Pekaway/ESP32-BLE-WIFI-SHUNT/docs/3D Renderings/Side.png

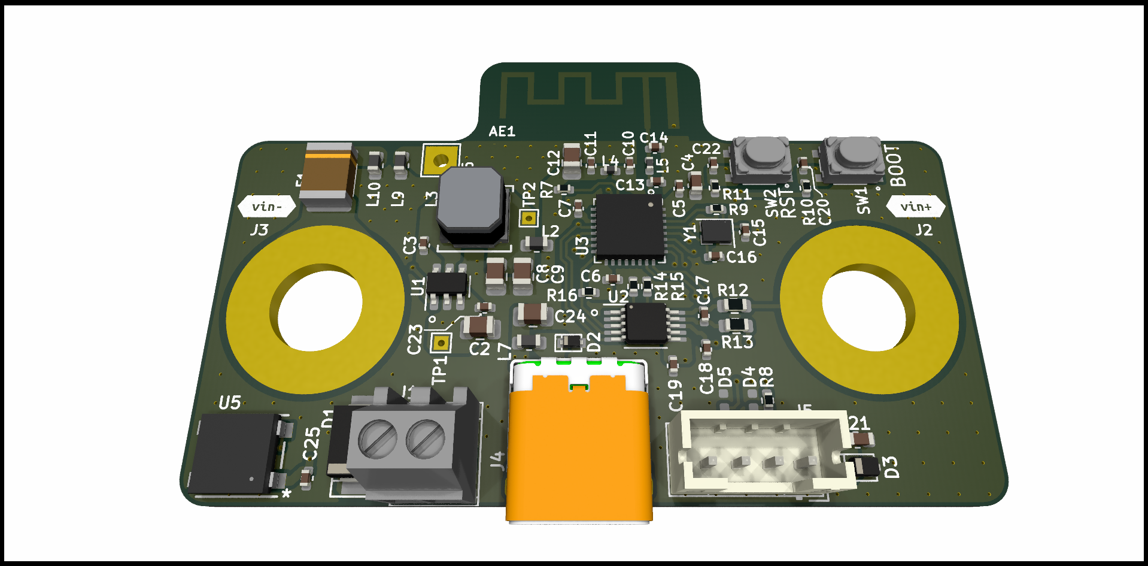
docs/3D Renderings/Side.png
