Pekaway/ESP32-BLE-WIFI-SHUNT/docs/3D Renderings/Top.png

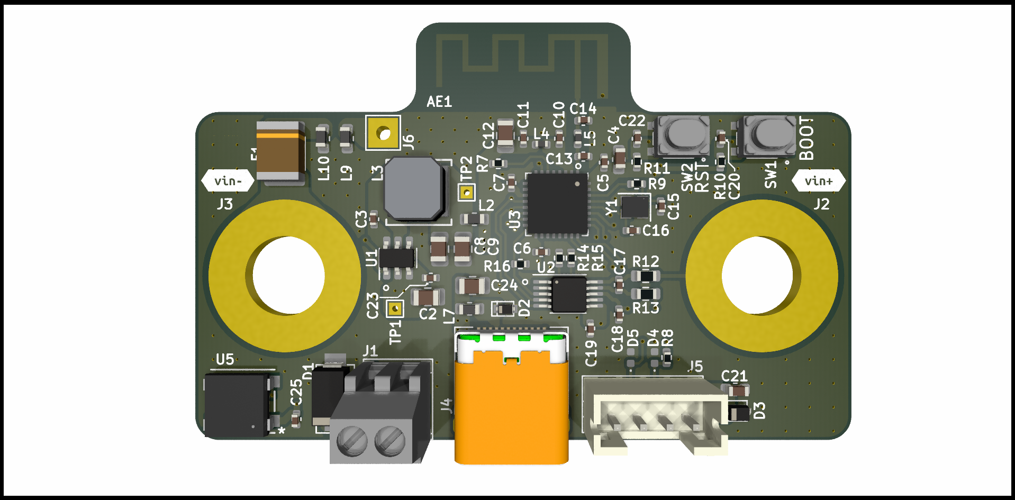
docs/3D Renderings/Top.png
