Pekaway/ESP32-BLE-WIFI-SHUNT/docs/3D Renderings/Angle 1.png

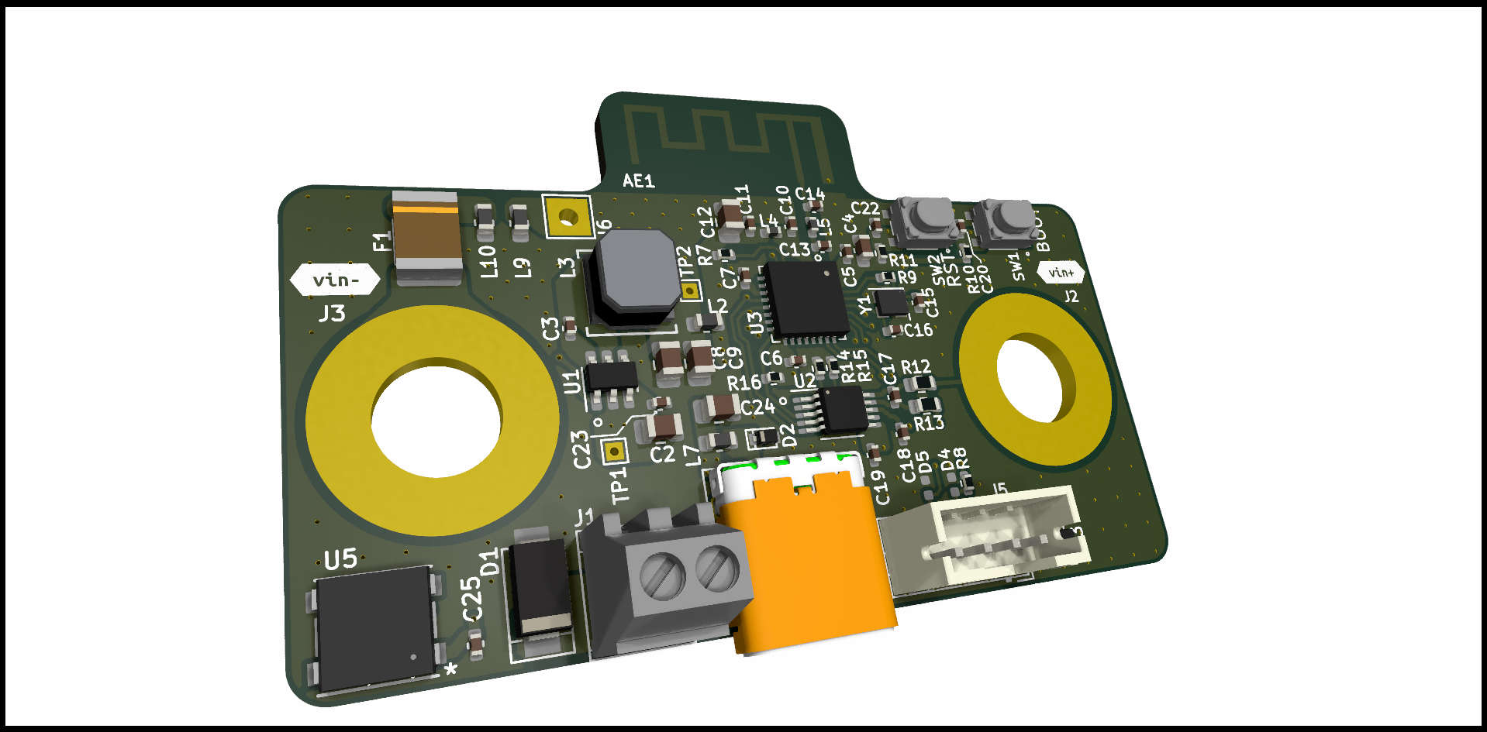
docs/3D Renderings/Angle 1.png
