Pekaway/ESP32-BLE-WIFI-SHUNT/docs/3D Renderings/Bottom.png

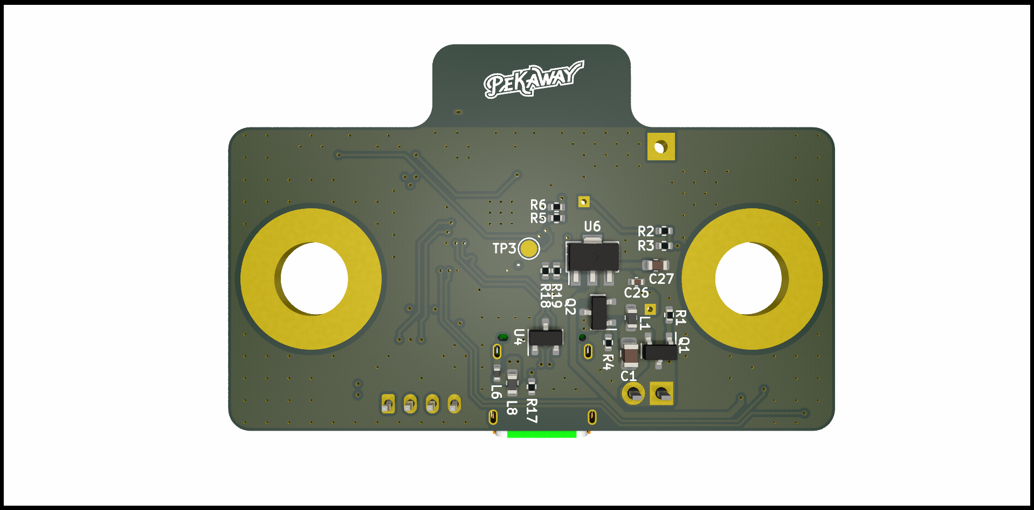
docs/3D Renderings/Bottom.png
