Pekaway/ESP32-BLE-WIFI-SHUNT/(threads)

Thread 1 (2024-09-11):

Update Punkte

WulleOnTour, 2024-09-11:
- Endpunke Bluetooth - Alle Einstellung die zum Shunt übertragen werden sollte auch Auslesbar sein
- Ladewirkunksgrad einstellbar Bsp: LFP 99% , Blei 95%.  Heißt bei einen Ladestrom von 10A in der Stunde, wird bei LFP nur 9,9Ah hinzu addiert, Bei Blei nur 9,5Ah

- Ladezustanderkennung wenn Baatterie Voll
	Spannung  - Ladeschlussspannung - Sollte ca 0,2 Volt unter der eigentlichen Ladespannung eingestellt sein.
	Strom  - (Bei Victron aus der Kapazität der Batterie Berechnet in Prozent - 300Ah 2% = 6a /Schweifstrom)
	Zeit   - (Victron - Zeit f. Ladezustand-Erkennung)
	Es muss die Spannung erreicht sein, sowie der Ladestrom unter den Wert X gefallen sein und das für mindesten Zeit X. Damit ist dann Sicher das die Batterie zu 100 % voll ist.

-2ter Input ADC
	Spannungsanzeige für Starterbatterie
	oder Mittelpunkt Bsp. 24 Volt System aus 12 Volt Batterien, Abweichung in Prozent

- Endladen (Peukert-Exponent)
	https://www.victronenergy.com/media/pg/SmartShunt_IP65/de/battery-capacity-and-peukert-exponent.html
	Eventuell einfach als Faktor angeben. Bsp. Faktor 1,1  bei 1A last wird 1,1Ah gezählt / 10a = 11Ah Eher bei Blei Batterien Intressant.

- Strom Schwellwert (Victron)
	Messfilter für kleine Ströme, also unter Wert Bsp. 0,01a wird als 0 erkannt.
	https://www.victronenergy.com/media/pg/SmartShunt_IP65/de/all-features-and-settings.html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

Thread 2 (2024-11-04):

Pinout of PCB components

dschmag, 2024-11-04:
Hi,
Is there a schematic or any documentation to find the correct pinout for
- I2C
- ws2812 led
- the buttons

I2C seems to be default, but that depends on the lib you use, I tried GPIO8 (SDA), GPIO9 (SCL), which did NOT work
a schematic would help a lot

I'm currently preparing an esphome config for this device (see https://esphome.io/components/sensor/ina226.html) so also the i2c address would be needed

dschmag, 2024-11-07:
Thanks,
works now with esphome in Home Assistant (sensors show up, but I did not test with current etc yet)

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

```

esphome:
  name: pekawayshut
  friendly_name: pekawayshut

esp32:
  board: esp32-c3-devkitm-1
  variant: esp32c3
  framework:
    type: arduino

# Enable logging
logger:
  level: DEBUG #VERY_VERBOSE

# Enable Home Assistant API
api:
  encryption:
    key: "xxxx"

ota:
  - platform: esphome
    password: "xxxx"

wifi:
  networks:
    - ssid: !secret wifi_ssid
      password: !secret wifi_password

  # Enable fallback hotspot (captive portal) in case wifi connection fails
  ap:
    ssid: "Pekawayshut Fallback Hotspot"
    password: "xxx"

captive_portal:

# https://esphome.io/components/i2c#i2c
# not default pins https://github.com/espressif/arduino-esp32/blob/master/variants/esp32c3/pins_arduino.h
i2c:
  sda: GPIO7
  scl: GPIO6
  scan: true # for debugging

# https://esphome.io/components/sensor/ina226.html
sensor:
  - platform: ina226 # from image name in repo and https://github.com/Pekaway/ESP32-BLE-WIFI-SHUNT/blob/main/docs/ESP32%20Shunt%20V2%20-%20Design%20Notes.pdf
    address: 0x40
    shunt_resistance: 0.000375 ohm # from https://github.com/Pekaway/ESP32-BLE-WIFI-SHUNT/blob/main/Esp32c3_Shunt_BLE_0.1.ino
    max_current: 1022 A # to check
    # adc time used for both, Bus Voltage and Shunt Voltage
    adc_time: 140 us
    adc_averaging: 4
    update_interval: 1s
    current:
      name: "INA226 Current"
    power:
      name: "INA226 Power"
    bus_voltage:
      name: "INA226 Bus Voltage"
    shunt_voltage:
      name: "INA226 Shunt Voltage"

# https://esphome.io/components/light/neopixelbus.html
light:
  - platform: neopixelbus
    type: GRB
    variant: WS2812
    pin: GPIO4
    num_leds: 1
    name: "NeoPixel Light"
```

Closed 2024-11-07.
