Pekaway/ESP32-BLE-WIFI-SHUNT/src/sensors/Shunt.cpp

#include "Shunt.h"
#include "../constants.h"
#include "../utils/ConfigManager.h"

Shunt& Shunt::getInstance() {
  static Shunt instance;
  return instance;
}

Shunt::Shunt() {
  logger.prependLog = [] { return "SHUNT"; };
}

bool Shunt::init() {
  ConfigManager& config = ConfigManager::getInstance();

  this->chargeEfficiency = config.get<uint8_t>(ConfigKey::CHARGE_EFFICIENCY);

  deviceCount = ina.begin(SHUNT_MAXIMUM_AMPS, SHUNT_MICRO_OHM, 255, 7, 6);
  while (deviceCount == 0) {
    logger.critical("No INA device found, retrying in 10 seconds...");
    delay(10000);
    deviceCount = ina.begin(SHUNT_MAXIMUM_AMPS, SHUNT_MICRO_OHM, 255, 7, 6);
  }

  char message[50];
  snprintf(message, sizeof(message), "Detected %d INA devices on the I2C bus", deviceCount);
  logger.info(message);

  ina.setBusConversion(8500);
  ina.setShuntConversion(8500);
  ina.setAveraging(128);
  ina.setMode(INA_MODE_CONTINUOUS_BOTH);
  ina.alertOnBusOverVoltage(true, 16000);

  loadConfig();

  return true;
}

double Shunt::getBusVoltage() { return ina.getBusMilliVolts(0) / 1000.0; }

double Shunt::getBusCurrent() {
  // negative is charging, positive is discharging
  return ina.getBusMicroAmps(0) / 1000000.0 * -1.0;
}

double Shunt::getPower() { return ina.getBusMicroWatts(0) / 1000000.0 * -1.0; }

double Shunt::getStateOfCharge() const { return calculateStateOfCharge(); }

void Shunt::setMaxCapacity(uint16_t const ampHours) {
  maxCapacityMilliAmpMs = ampHours * 60LL * 60LL * 1000LL * 1000LL;

  ConfigManager& config = ConfigManager::getInstance();
  config.set(ConfigKey::MAXIMUM_CAPACITY_MAMS, maxCapacityMilliAmpMs);
  config.saveConfig();

  char message[50];
  snprintf(message, sizeof(message), "Max capacity set to %d Ah", ampHours);
  logger.info(message);
}

void Shunt::setCurrentStateOfCharge(uint8_t percentage) {
  if (percentage > 100) percentage = 100;
  currentCapacityMilliAmpMs = (maxCapacityMilliAmpMs / 100) * percentage;

  saveStateToConfig();
  lastStoredCapacityMilliAmpMs = currentCapacityMilliAmpMs;

  char message[50];
  snprintf(message, sizeof(message), "SOC set to %d%%", percentage);
  logger.info(message);
}

void Shunt::setChargeEfficiency(uint8_t percentage) {
  if (percentage > 100) percentage = 100;

  ConfigManager& config = ConfigManager::getInstance();
  config.set<uint8_t>(ConfigKey::CHARGE_EFFICIENCY, percentage);
  config.saveConfig();

  this->chargeEfficiency = percentage;

  char message[50];
  snprintf(message, sizeof(message), "Charge efficiency set to %d%%", percentage);
  logger.info(message);
}

double Shunt::getChargeEfficiency() const { return this->chargeEfficiency; }

uint64_t Shunt::getMaxCapacity() const { return maxCapacityMilliAmpMs / (60LL * 60LL * 1000LL * 1000LL); }

bool Shunt::loadConfig() {
  ConfigManager& config = ConfigManager::getInstance();

  maxCapacityMilliAmpMs = config.get<uint64_t>(ConfigKey::MAXIMUM_CAPACITY_MAMS, 100LL * 60LL * 60LL * 1000LL * 1000LL);
  logger.info(String(maxCapacityMilliAmpMs).c_str());

  if (config.hasKey(ConfigKey::CURRENT_CAPACITY_MAMS)) {
    currentCapacityMilliAmpMs = config.get<long long>(ConfigKey::CURRENT_CAPACITY_MAMS);
  }

  fullChargeVoltage = config.get<float>(ConfigKey::FULL_CHARGE_VOLTAGE);
  fullChargeCurrent = config.get<float>(ConfigKey::FULL_CHARGE_CURRENT);
  fullChargeDuration = config.get<uint32_t>(ConfigKey::FULL_CHARGE_DURATION) * 60 * 1000;

  lastStoredCapacityMilliAmpMs = currentCapacityMilliAmpMs;

  char message[100];
  snprintf(message, sizeof(message), "Loaded max capacity: %lld mA-ms, SOC: %f%%", maxCapacityMilliAmpMs,
           calculateStateOfCharge());
  logger.info(message);

  return true;
}

void Shunt::saveStateToConfig() const {
  ConfigManager& config = ConfigManager::getInstance();

  config.set(ConfigKey::CURRENT_CAPACITY_MAMS, currentCapacityMilliAmpMs);
  config.saveConfig();
}

void Shunt::update() {
  auto const currentMillis = millis();

  if (lastUpdateMillis > 0) {
    uint64_t capacityDeltaMilliAmpMs = 0;
    // Calculate consumed or recharged capacity since last update
    auto const elapsedMs = currentMillis - lastUpdateMillis;
    auto const busCurrent = getBusCurrent();

    if (busCurrent > 0.0f) {
      // Charging
      uint64_t const currentAmps = abs(busCurrent) * chargeEfficiency / 100;
      capacityDeltaMilliAmpMs = (currentAmps * 1000 * elapsedMs);

      currentCapacityMilliAmpMs += capacityDeltaMilliAmpMs;
    } else if (busCurrent < 0.0f) {
      // Discharging
      capacityDeltaMilliAmpMs = (abs(busCurrent) * 1000 * elapsedMs);

      currentCapacityMilliAmpMs -= capacityDeltaMilliAmpMs;
    }

    clampStateOfCharge();
  }

  auto const voltage = getBusVoltage();
  auto const current = getBusCurrent();
  auto const soc = calculateStateOfCharge();

  // Both conditions must be met:
  // 1. Voltage must be at or above threshold
  // 2. Current must be below threshold but greater than zero
  bool const chargingConditionsMet = (voltage >= fullChargeVoltage) && (current < fullChargeCurrent) &&
                                     (current > 0.0) && (soc < 99.0);  // Only trigger if not already at 100%

  if (chargingConditionsMet) {
    if (!fullChargeConditionMet) {
      fullChargeConditionMet = true;
      fullChargeConditionStartTime = currentMillis;
      logger.info("Full charge conditions detected, starting timer");
    } else if (currentMillis - fullChargeConditionStartTime >= fullChargeDuration) {
      logger.info("Battery full charge criteria met for required duration");
      setCurrentStateOfCharge(100);
      fullChargeConditionMet = false;
    }
  } else if (fullChargeConditionMet) {
    fullChargeConditionMet = false;
    logger.info("Full charge conditions no longer met, resetting timer");
  }

  if (constexpr auto autoSaveInterval = AUTO_SAVE_INTERVAL * 1000;
      currentMillis - lastStorageMillis >= autoSaveInterval) {
    lastStorageMillis = currentMillis;

    if (fullChargeConditionMet) {
      currentCapacityMilliAmpMs = maxCapacityMilliAmpMs;
    }

    saveStateToConfig();
    lastStoredCapacityMilliAmpMs = currentCapacityMilliAmpMs;
  }

  lastUpdateMillis = currentMillis;
}

double Shunt::calculateStateOfCharge() const {
  if (maxCapacityMilliAmpMs <= 0) return 0;

  return static_cast<double>(currentCapacityMilliAmpMs) / maxCapacityMilliAmpMs * 100;
}

double Shunt::getTTGO() {
  double ttgo = 0.0;
  constexpr double maxTTGO = 9999.0;

  if (double const busCurrent = getBusCurrent(); busCurrent > 0.01f) {
    // Charging - calculate time to full
    uint64_t const remaining_capacity_milli_amp_ms = maxCapacityMilliAmpMs - currentCapacityMilliAmpMs;
    int64_t const chargingCurrentMilliA = abs(busCurrent) * 1000.0f * (static_cast<float>(chargeEfficiency) / 100.0f);

    if (chargingCurrentMilliA > 0) {
      return remaining_capacity_milli_amp_ms / chargingCurrentMilliA;
    }
    ttgo = maxTTGO;
  } else if (busCurrent < -0.01f) {
    // Discharging - calculate time remaining
    double const dischargingCurrentMilliA = abs(busCurrent * 1000.0f);

    if (dischargingCurrentMilliA > 0) {
      return static_cast<double>(currentCapacityMilliAmpMs) / dischargingCurrentMilliA;
    }
    ttgo = maxTTGO;
  } else {
    // Current near zero - consider it infinite or N/A
    ttgo = maxTTGO;
  }

  // Convert hours to milliseconds for return value
  return ttgo * 60.0 * 60.0 * 1000.0;
}

void Shunt::clampStateOfCharge() {
  if (currentCapacityMilliAmpMs > maxCapacityMilliAmpMs) {
    currentCapacityMilliAmpMs = maxCapacityMilliAmpMs;
  }

  if (currentCapacityMilliAmpMs < 0) {
    currentCapacityMilliAmpMs = 0;
  }
}

void Shunt::setFullChargeVoltage(float const voltage) {
  ConfigManager& config = ConfigManager::getInstance();
  fullChargeVoltage = voltage;
  config.set<float>(ConfigKey::FULL_CHARGE_VOLTAGE, voltage);
  config.saveConfig();

  char message[50];
  snprintf(message, sizeof(message), "Full charge voltage set to %.1fV", voltage);
  logger.info(message);
}

void Shunt::setFullChargeCurrent(float const current) {
  ConfigManager& config = ConfigManager::getInstance();
  fullChargeCurrent = current;
  config.set<float>(ConfigKey::FULL_CHARGE_CURRENT, current);
  config.saveConfig();

  char message[50];
  snprintf(message, sizeof(message), "Full charge current set to %.1fA", current);
  logger.info(message);
}

void Shunt::setFullChargeDuration(uint32_t const minutes) {
  ConfigManager& config = ConfigManager::getInstance();
  fullChargeDuration = minutes * 60 * 1000;  // Convert minutes to ms
  config.set<uint32_t>(ConfigKey::FULL_CHARGE_DURATION, minutes);
  config.saveConfig();

  char message[50];
  snprintf(message, sizeof(message), "Full charge duration set to %d min", minutes);
  logger.info(message);
}
