Pekaway/ESP32-BLE-WIFI-SHUNT/src/CallbackHandler.h

#ifndef CALLBACKHANDLER_H
#define CALLBACKHANDLER_H

#include <sensors/ExternalBattery.h>
#include <sensors/Shunt.h>
#include <utils/ConfigManager.h>
#include <utils/UpdateManager.h>
#include <Arduino.h>
#include <BLECharacteristic.h>
#include <Logger.h>

class CallbackHandler {
 public:
  CallbackHandler(CallbackHandler const&) = delete;
  CallbackHandler& operator=(CallbackHandler const&) = delete;

  static CallbackHandler& getInstance();

  void init();
  void closeSetup();
  [[nodiscard]] bool isSetupAllowed() const;

  void handleMQTTConfig(String const& value);
  void handleWiFi(String const& value);
  void handleBatteryConfig(String const& value);
  void handleShuntConfig(String const& value);
  void handleResetAndDefaultConfig(String const& value);
  void handleOTAUpdate(uint8_t* data, size_t length);

  void updateShuntStatus(BLECharacteristic* shuntStatusChar) const;
  void updateBatteryConfigCharacteristic(BLECharacteristic* batteryConfigChar) const;
  void updateWifiConfigCharacteristic(BLECharacteristic* wifiConfigChar) const;
  void updateMqttConfigCharacteristic(BLECharacteristic* mqttConfigChar) const;
  void updateShuntConfigCharacteristic(BLECharacteristic* shuntConfigChar) const;

 private:
  CallbackHandler();
  ~CallbackHandler() = default;

  Logger logger = Logger(Serial);
  Shunt& shunt = Shunt::getInstance();
  ConfigManager& config = ConfigManager::getInstance();
  ExternalBattery& externalBattery = ExternalBattery::getInstance();
  bool setupAllowed = true;
  uint8_t expectedSeqNum = 0;

  bool isAllowed();
};

#endif  // CALLBACKHANDLER_H
