Pekaway/ESP32-BLE-WIFI-SHUNT/src/network/BluetoothManager.h

#ifndef BLUETOOTHMANAGER_H
#define BLUETOOTHMANAGER_H

#include <functional>
#include <string>
#include <utility>
#include <BLE2902.h>
#include <BLEDevice.h>
#include <BLEServer.h>
#include <BLEUtils.h>
#include <Logger.h>

class BluetoothManager {
 public:
  static BluetoothManager& getInstance();

  BluetoothManager(BluetoothManager const&) = delete;
  BluetoothManager& operator=(BluetoothManager const&) = delete;

  void init(char const* serverName);
  void startAdvertising();
  void handle();
  [[nodiscard]] bool isConnected() const;

  BLECharacteristic* createReadCharacteristic(char const* charUUID);
  BLECharacteristic* createNotifyCharacteristic(char const* charUUID);
  BLECharacteristic* createWriteCharacteristic(char const* charUUID, std::function<void(String const&)> callback,
                                               uint8_t properties = BLECharacteristic::PROPERTY_WRITE);
  BLECharacteristic* createBinaryWriteCharacteristic(char const* charUUID, std::function<void(uint8_t*, size_t)> callback,
                                                     uint8_t properties = BLECharacteristic::PROPERTY_WRITE);

 private:
  BluetoothManager();
  ~BluetoothManager() = default;

  Logger logger = Logger(Serial);

  BLEServer* pServer = nullptr;
  BLEService* service = nullptr;
  bool deviceConnected = false;

  class ServerCallbacks final : public BLEServerCallbacks {
    BluetoothManager* manager;

   public:
    explicit ServerCallbacks(BluetoothManager* mgr) : manager(mgr) {}
    void onConnect(BLEServer* pServer) override;
    void onDisconnect(BLEServer* pServer) override;
  };

  class CharacteristicCallbacks final : public BLECharacteristicCallbacks {
    std::function<void(String const&)> callback;

   public:
    explicit CharacteristicCallbacks(std::function<void(String const&)> cb) : callback(std::move(cb)) {}
    void onWrite(BLECharacteristic* pCharacteristic) override;
  };

  class BinaryCharacteristicCallbacks final : public BLECharacteristicCallbacks {
    std::function<void(uint8_t*, size_t)> callback;

   public:
    explicit BinaryCharacteristicCallbacks(std::function<void(uint8_t*, size_t)> cb) : callback(std::move(cb)) {}
    void onWrite(BLECharacteristic* pCharacteristic) override;
  };
};

#endif  // BLUETOOTHMANAGER_H
