Pekaway/ESP32-BLE-WIFI-SHUNT/(commit log)

2024-04-24 add SOC Limit, add pixel LED, add setup close after 2min, add store only ofter change of 0,1Ah
2025-03-08 pio init
    [partition.csv]
2025-03-18 remove ota partitions
    [partition.csv]
2025-03-18 successful mqtt connection, config save, wifi params
    [partition.csv]
2025-03-21 add chargeEfficiency
2025-03-21 hass sensor
2025-03-27 fix some minor issues with bt and mqtt
    [BluetoothManager.cpp, MQTTManager.cpp]
2025-04-08 expose current ip through wifi characteristic
2025-04-12 add ResetManager for handling reset conditions and boot count; update related components
    [CallbackHandler.h, Shunt.cpp, constants.h, main.cpp]
2025-04-12 add NeoPixel class for LED control; integrate with ResetManager and main logic
    [constants.h, main.cpp]
2025-04-12 add methods to update BLE characteristics for shunt, battery, WiFi, and MQTT configurations; refactor related logic into CallbackHandler
2025-04-12 add ExternalBattery class for voltage reading; define external battery pin in constants
2025-04-22 update shunt resistance constant from 375 to 100 micro-ohms
2025-04-22 add calibration constant for voltage reading in ExternalBattery class
2025-04-25 update shunt resistance constant from 100 to 60 micro-ohms
2025-04-27 add UartManager class for UART communication and update constants
2025-04-27 add external voltage reading and update MQTT publishing for battery metrics
2025-04-28 update shunt resistance constant from 60 to 100 micro-ohms
2025-05-01 add shunt configuration handling and LED control
2025-05-03 refactor Bluetooth and Shunt management: remove unused config keys, adjust auto-save interval, and improve capacity calculations
2025-05-03 refactor Shunt management: update capacity handling to use uint16_t, rename config keys, and improve default values
2025-05-03 refactor Shunt and NeoPixel management: adjust setup time, improve LED handling, and enhance capacity calculations
2025-05-28 add external battery offset
2025-05-28 allow setting soc and max capacity via mqtt
2025-05-28 add versioning support and external battery calibration constants
2025-05-28 remove unnecessary logging of battery charging and discharging in Shunt class
2025-07-07 allow for ota update in partition table
    [partition.csv]
2025-11-25 disable led on scheduled restart
